leahcornelius/6802/(list of files, drawings)

Other design files:
hardware/logic/v2.circ
