leahcornelius/6802/hardware/v2-kicad/6802 v2/6802 v2.kicad_pcb

## KiCad design hardware/v2-kicad/6802 v2/6802 v2.kicad_pcb (2023-06-05)

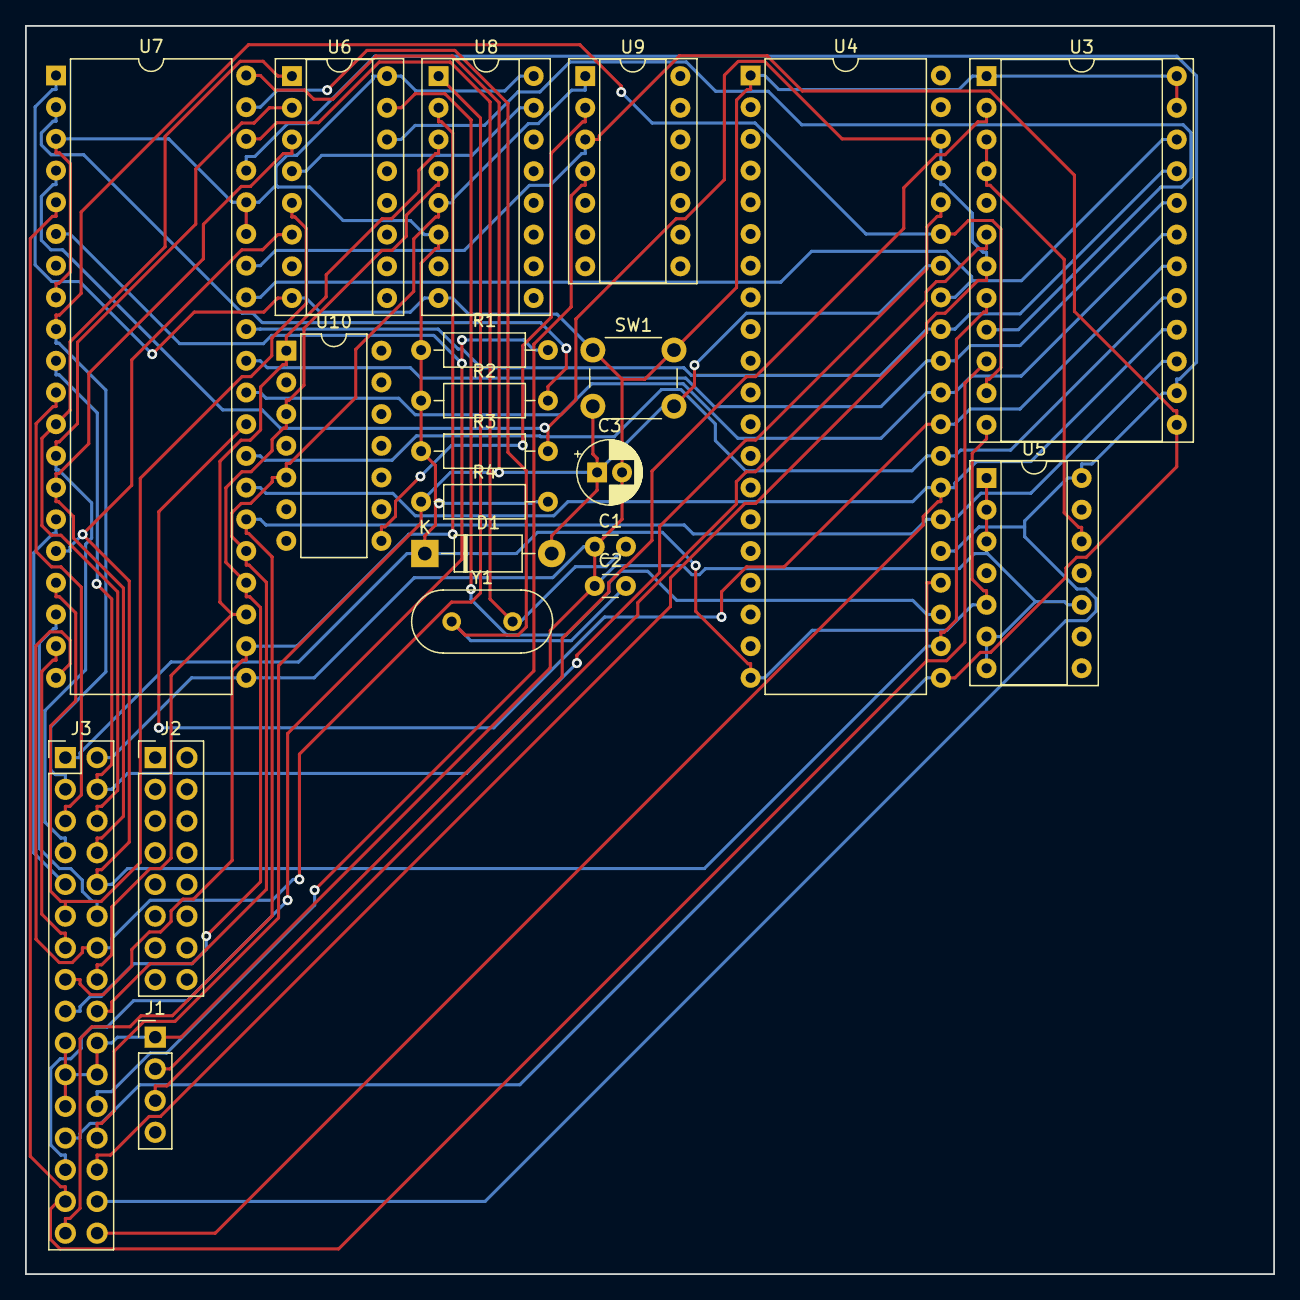
[picture p1: board 6802 v2.kicad_pcb from above]

Board: 2 copper layers, 100.0 x 100.0 mm, 21 parts (0 on the bottom side), 43 nets.

Parts:
C1, C2: 27pF; C_Disc_D3.0mm_W1.6mm_P2.50mm
C3: 10uF; CP_Radial_D5.0mm_P2.00mm
D1: 1N5819; D_DO-41_SOD81_P10.16mm_Horizontal
J1: UART connector; PinHeader_1x04_P2.54mm_Vertical
J2: Conn_02x08_Row_Letter_First; PinHeader_2x08_P2.54mm_Vertical
J3: Conn_02x16_Counter_Clockwise; PinHeader_2x16_P2.54mm_Vertical
R1, R2, R3, R4: 3.3k; R_Axial_DIN0207_L6.3mm_D2.5mm_P10.16mm_Horizontal
SW1: Reset; SW_PUSH_6mm
U3: MC68B50; DIP-24_W15.24mm_Socket
U4: 6821; DIP-40_W15.24mm
U5: 74LS90; DIP-14_W7.62mm_Socket
U6, U8: 74LS138; DIP-16_W7.62mm_Socket
U7: MC6802; DIP-40_W15.24mm
U9: 74LS04; DIP-14_W7.62mm_Socket
U10: 74HC04; DIP-14_W7.62mm
Y1: 4MHz Crystal; Crystal_HC49-U_Vertical

Connections:
+5V: D1.1 (K), J3.1, R1.1, R2.1, R3.1, R4.2, U3.12 (VCC), U4.20 (VCC), U5.5 (VCC), U6.16 (VCC), U7.3 (MR), U7.8 (VCC), U7.35 (VCC_STANDBY), U7.36 (RE), U8.6 (E3), U8.16 (VCC)
A0: J3.3, U3.11 (RS), U4.35 (RS1), U7.9 (A0)
A1: J3.4, U4.36 (RS0), U7.10 (A1)
A2: J3.5, U7.11 (A2)
A3: J3.6, U6.1 (A0), U7.12 (A3)
A4: J3.7, U6.2 (A1), U7.13 (A4)
A5: J3.8, U6.3 (A2), U7.14 (A5)
A6: J3.9, U7.15 (A6)
A7: J3.10, U3.8 (CS0), U4.22 (CS0), U6.6 (E3), U7.16 (A7)
A8: J3.11, U6.5 (E2), U7.17 (A8)
A9: J3.12, U7.18 (A9)
A10: J3.13, U7.19 (A10)
A11: J3.14, U7.20 (A11), U8.1 (A0)
A12: J3.15, U7.22 (A12), U8.2 (A1)
A13: J3.16, U7.23 (A13), U8.3 (A2), U10.1
A14: J3.17, U7.24 (A14), U8.4 (E1), U10.3
A15: J3.18, U7.25 (A15), U8.5 (E2), U9.1, U10.5
CLK_{UART0}: U3.3 (Rx_CLK), U3.4 (Tx_CLK), U5.12 (Q0)
D0: U3.22 (D0), U4.33 (D0), U7.33 (D0)
D1: U3.21 (D1), U4.32 (D1), U7.32 (D1)
D2: U3.20 (D2), U4.31 (D2), U7.31 (D2)
D3: U3.19 (D3), U4.30 (D3), U7.30 (D3)
D4: U3.18 (D4), U4.29 (D4), U7.29 (D4)
D5: U3.17 (D5), U4.28 (D5), U7.28 (D5)
D6: J3.32, U3.16 (D6), U4.27 (D6), U7.27 (D6)
D7: J3.31, U3.15 (D7), U4.26 (D7), U7.26 (D7)
E: J3.30, U3.14 (E), U4.25 (ENABLE), U5.14 (CP0), U7.37 (E)
GND: C1.1, C2.1, C3.2, J1.1, J3.2, J3.19, J3.20, J3.21, J3.22, J3.23, SW1.1, U3.1 (VSS), U3.23 (~DCD), U3.24 (~CTS), U4.1 (VSS), U5.1 (CP1..3), U5.2 (R0(1)), U5.3 (R0(2)), U5.6 (R9(1)), U5.7 (R9(2)), U5.10 (GND), U6.8 (GND), U7.1 (VSS), U7.21 (VSS), U8.8 (GND)
unnamed: C2.2, U7.39 (EXTAL), Y1.1
unnamed: C1.2, U7.38 (XTAL), Y1.2
RX: J1.2, U3.2 (Rx_Data)
R/~W: J3.25, U3.13 (R/~W), U4.21 (R/~W), U7.34 (R/~W), U9.3
TX: J1.3, U3.6 (Tx_Data)
VMA: J3.29, U3.10 (CS1), U4.24 (CS1), U7.5 (VMA)
~CS^{13_{H}}: U6.4 (E1), U8.15 (O0)
~CS_{PIA}: U4.23 (~CS2), U6.15 (O0)
~CS_{ROM}: U9.2, U10.8
~CS_{UART0}: U3.9 (~CS2), U6.14 (O1)
~HALT: R2.2, U7.2 (~HALT)
~IRQ: J3.28, R3.2, U3.7 (~IRQ), U4.37 (~IRQB), U4.38 (~IRQA), U7.4 (~IRQ)
~NMI: J3.27, R1.2, U7.6 (~NMI)
~RESET: C3.1, D1.2 (A), J3.26, R4.1, SW1.2, U4.34 (~RESET), U7.40 (~RESET)
~R: J3.24, U9.4
