leahcornelius/6802/hardware/kicad/6802 v1.kicad_pcb

## KiCad design hardware/kicad/6802 v1.kicad_pcb (2023-05-27)

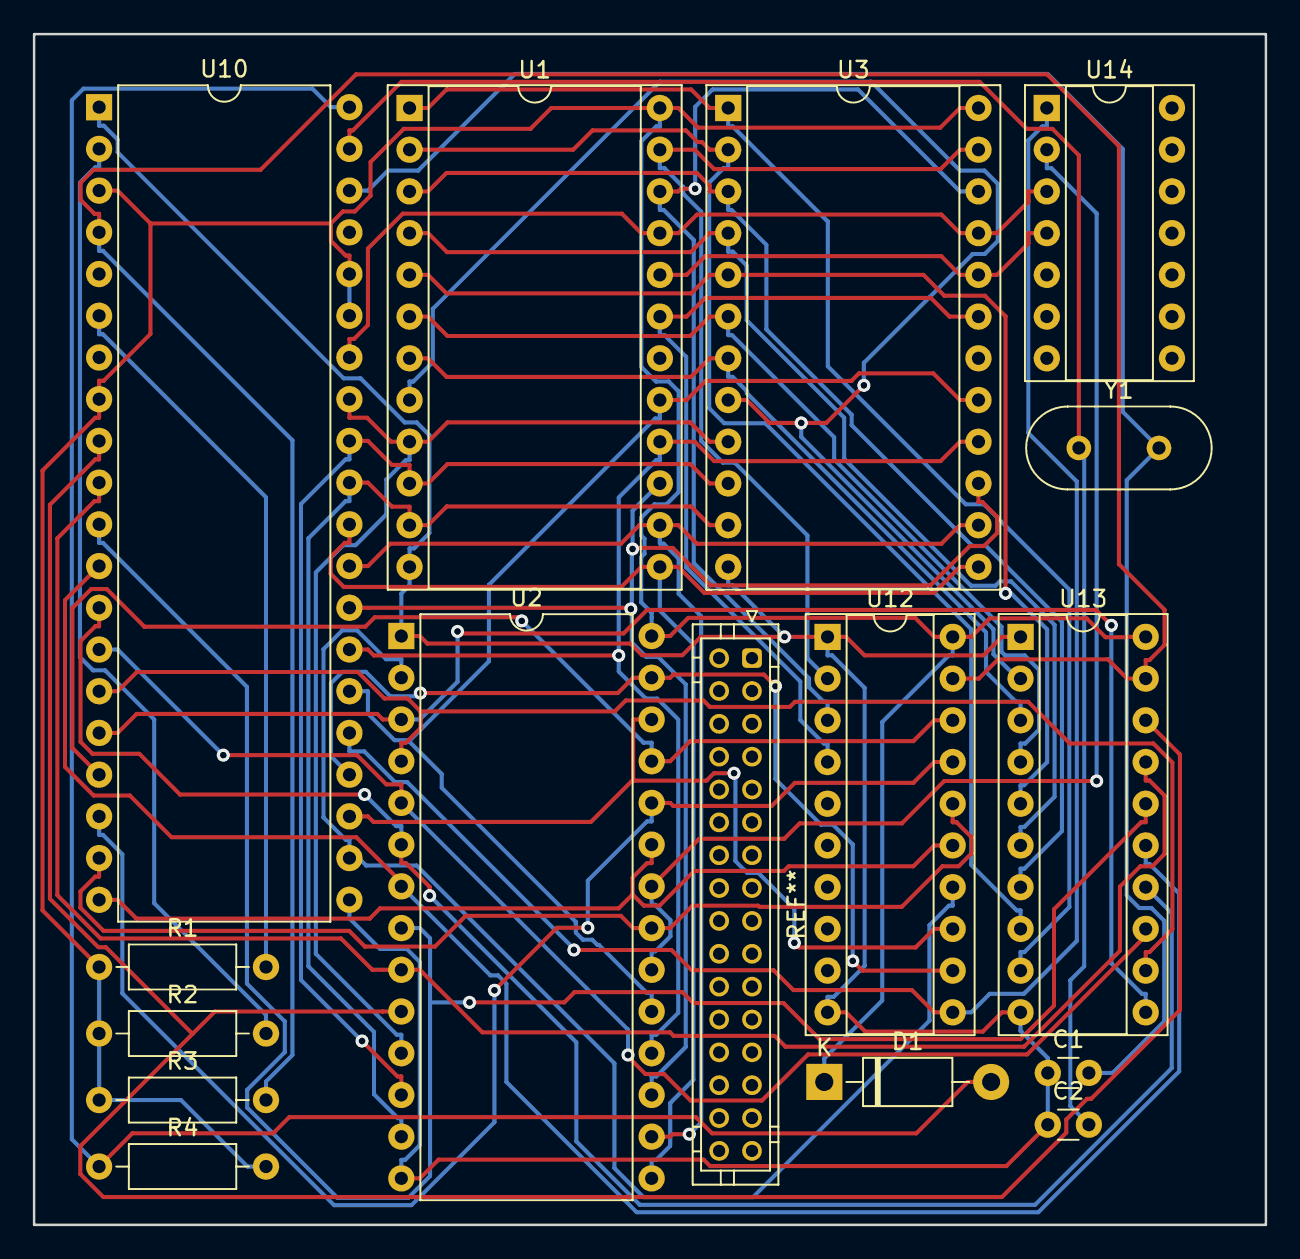
[picture p2: board 6802 v1.kicad_pcb from above]

Board: 2 copper layers, 75.0 x 72.5 mm, 15 parts (0 on the bottom side), 46 nets.

Parts:
C1, C2: 27pF; C_Disc_D3.0mm_W1.6mm_P2.50mm
D1: 1N5819; D_DO-41_SOD81_P10.16mm_Horizontal
R1, R2, R3, R4: 3.3k; R_Axial_DIN0207_L6.3mm_D2.5mm_P10.16mm_Horizontal
U1, U3: UM6116; DIP-24_W15.24mm_Socket
U2: 27C512; DIP-28_W15.24mm
U10: MC6802; DIP-40_W15.24mm
U12, U13: 74LS245; DIP-20_W7.62mm_Socket
U14: 74LS04; DIP-14_W7.62mm_Socket
Y1: 4MHz Crystal; Crystal_HC49-U_Vertical

Connections:
+5V: D1.1 (K), R1.1, R2.1, R3.1, R4.2, U1.24 (VCC), U2.28 (VCC), U3.24 (VCC), U10.3 (MR), U10.8 (VCC), U10.35 (VCC_STANDBY), U10.36 (RE), U12.20 (VCC), U13.20 (VCC)
A0: U2.10 (A0), U10.9 (A0), U13.18 (B0)
A1: U2.9 (A1), U10.10 (A1), U13.17 (B1)
A2: U2.8 (A2), U10.11 (A2), U13.16 (B2)
A3: U2.7 (A3), U10.12 (A3), U13.15 (B3)
A4: U2.6 (A4), U10.13 (A4), U13.14 (B4)
A5: U2.5 (A5), U10.14 (A5), U13.13 (B5)
A6: U2.4 (A6), U10.15 (A6), U13.12 (B6)
A7: U2.3 (A7), U10.16 (A7), U13.11 (B7)
A8: U2.25 (A8), U10.17 (A8), U12.18 (B0)
A9: U2.24 (A9), U10.18 (A9), U12.17 (B1)
A10: U2.21 (A10), U10.19 (A10), U12.16 (B2)
A11: U2.23 (A11), U10.20 (A11), U12.15 (B3)
A12: U2.2 (A12), U10.22 (A12), U12.14 (B4)
A13: U2.26 (A13), U10.23 (A13), U12.13 (B5)
A14: U2.27 (A14), U10.24 (A14), U12.12 (B6)
A15: U10.25 (A15), U12.11 (B7), U14.1
A_{b}0: U1.8 (A0), U3.8 (A0), U13.2 (A0)
A_{b}1: U1.7 (A1), U3.7 (A1), U13.3 (A1)
A_{b}2: U1.6 (A2), U3.6 (A2), U13.4 (A2)
A_{b}3: U1.5 (A3), U3.5 (A3), U13.5 (A3)
A_{b}4: U1.4 (A4), U3.4 (A4), U13.6 (A4)
A_{b}5: U1.3 (A5), U3.3 (A5), U13.7 (A5)
A_{b}6: U1.2 (A6), U3.2 (A6), U13.8 (A6)
A_{b}7: U1.1 (A7), U3.1 (A7), U13.9 (A7)
A_{b}8: U1.23 (A8), U3.23 (A8), U12.2 (A0)
A_{b}9: U1.22 (A9), U3.22 (A9), U12.3 (A1)
A_{b}10: U1.19 (A10), U3.19 (A10), U12.4 (A2)
D0: U1.9 (Q1), U2.11 (D0), U3.9 (Q1), U10.33 (D0)
D1: U1.10 (Q2), U2.12 (D1), U3.10 (Q2), U10.32 (D1)
D2: U1.11 (Q3), U2.13 (D2), U3.11 (Q3), U10.31 (D2)
D3: U1.13 (Q4), U2.15 (D3), U3.13 (Q4), U10.30 (D3)
D4: U1.14 (Q5), U2.16 (D4), U3.14 (Q5), U10.29 (D4)
D5: U1.15 (Q6), U2.17 (D5), U3.15 (Q6), U10.28 (D5)
D6: U1.16 (Q7), U2.18 (D6), U3.16 (Q7), U10.27 (D6)
D7: U1.17 (Q8), U2.19 (D7), U3.17 (Q8), U10.26 (D7)
DMA: R3.2, U10.4 (~IRQ), U12.19 (CE), U13.19 (CE)
GND: C1.1, C2.1, U1.12 (GND), U2.1 (A15), U2.14 (GND), U3.12 (GND), U10.1 (VSS), U10.21 (VSS), U12.1 (A->B), U12.10 (GND), U13.1 (A->B), U13.10 (GND)
unnamed: C2.2, U10.39 (EXTAL), Y1.1
unnamed: C1.2, U10.38 (XTAL), Y1.2
R/~W: U1.21 (~WE), U3.21 (~WE), U10.34 (R/~W), U14.3
~CS_{ROM}: U2.20 (~CE), U2.22 (~OE), U14.2
~IRQ: R2.2, U10.2 (~HALT)
~NMI: R1.2, U10.6 (~NMI)
~RESET: D1.2 (A), R4.1, U10.40 (~RESET)
~R: U1.20 (~OE), U3.20 (~OE), U14.4
