leahcornelius/6802/(commit log)

2023-05-16 Create assembly program template
2023-05-16 add uart
    [6802 SC1.kicad_sch, io.kicad_sch, memory.kicad_sch]
2023-05-16 fix kicad
    [6802 SC1.kicad_sch, 6802 v1 (1).kicad_sch, 6802 v1.csv, 6802 v1.kicad_pcb, 6802 v1.kicad_sch, address_logic.kicad_sch, cpu.kicad_sch, inputoutput.kicad_sch]
2023-05-16 Kicad works again maybe?
2023-05-19 Update gitnore
    [6802 v1.kicad_sch, connectors.kicad_sch, cpu.kicad_sch, gluelogic.kicad_sch, io.kicad_sch, memory.kicad_sch]
2023-05-27 Uart working
2023-05-27 Start PCB design
    [6802 v1.kicad_pcb, connectors.kicad_sch, cpu.kicad_sch, gluelogic.kicad_sch, io.kicad_sch, memory.kicad_sch]
2023-05-27 Disable tx ready interupts when no pending bytes (hacky fix?)
    [uart.asm]
2023-05-29 Improve UART test code and add comments
2023-06-05 Lots of changes
    [6802 v2.kicad_pcb, 6802 v2.kicad_sch, address_logic.kicad_sch, connectors.kicad_sch, cpu.kicad_sch, gluelogic.kicad_sch, io.kicad_sch, memory.kicad_sch]
